jonnyarnold/wordclock/pictures/1_pieces.jpg

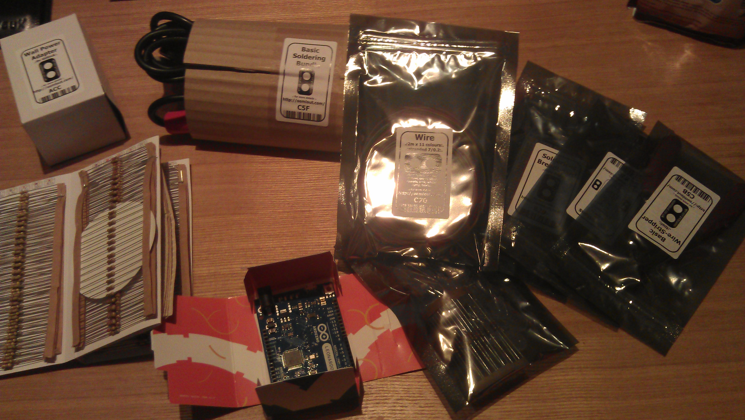
pictures/1_pieces.jpg
