jonnyarnold/wordclock/pictures/3_stencil_cork.jpg

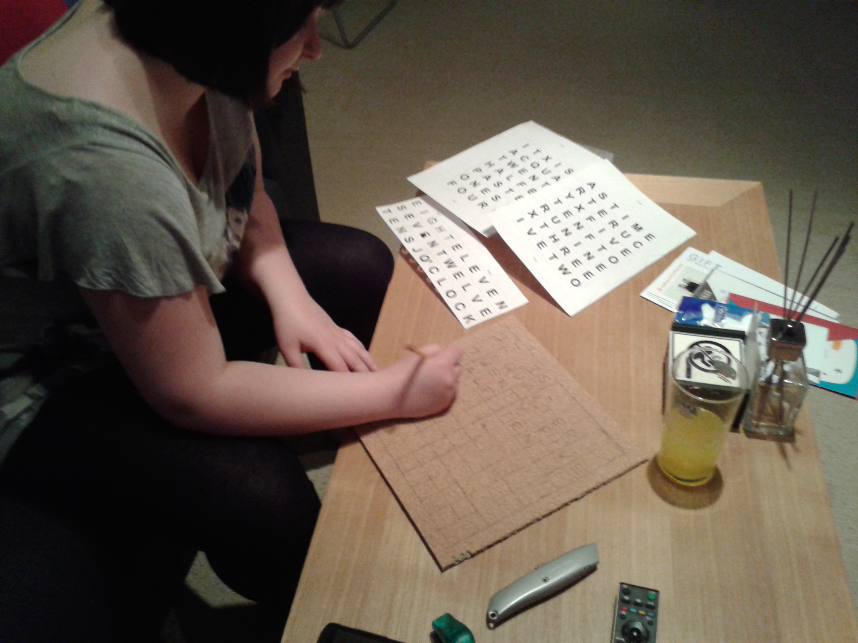
pictures/3_stencil_cork.jpg
