jonnyarnold/wordclock/pictures/4_cork_frame.jpg

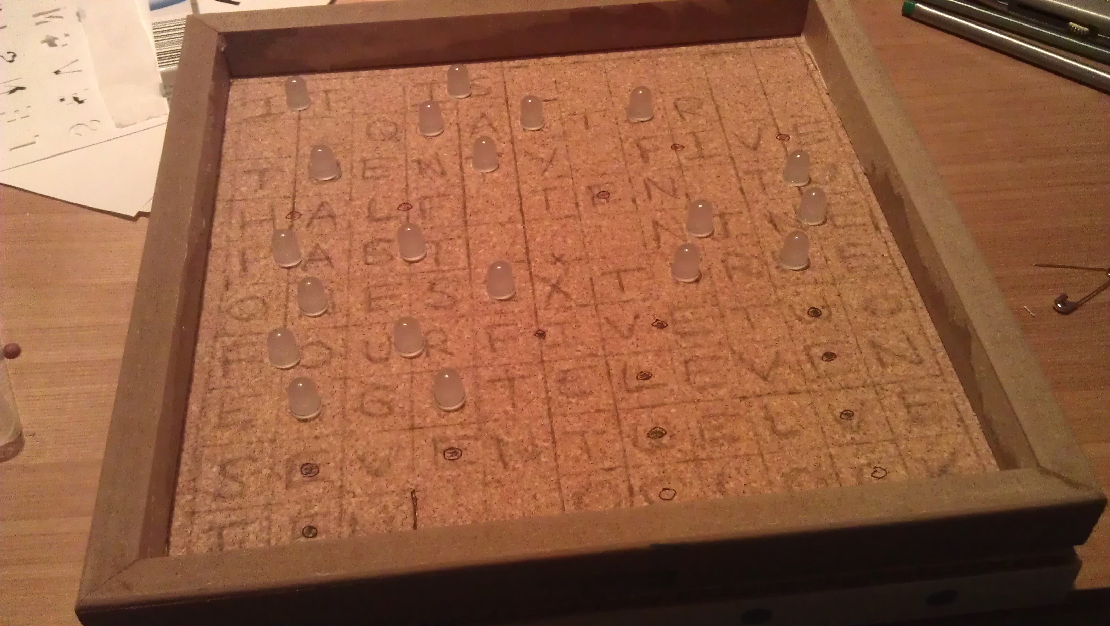
pictures/4_cork_frame.jpg
