jonnyarnold/wordclock/pictures/5_cork.jpg

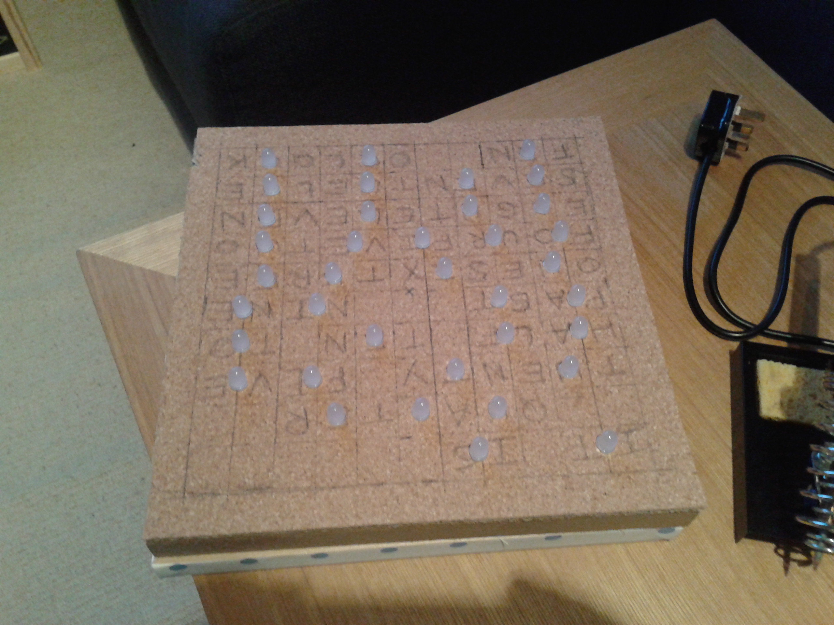
pictures/5_cork.jpg
