jonnyarnold/wordclock/pictures/6_arduino_cork.jpg

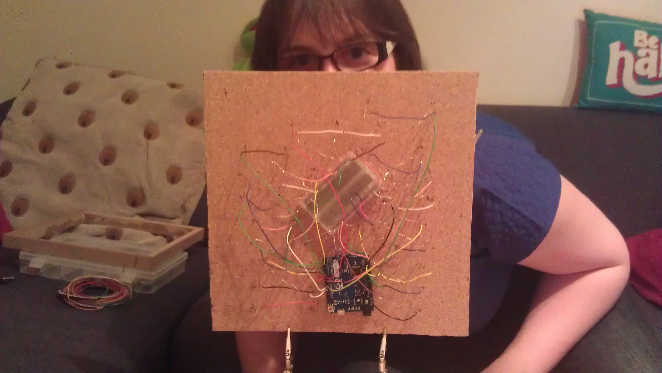
pictures/6_arduino_cork.jpg
