jonnyarnold/wordclock/pictures/7_tracing.jpg

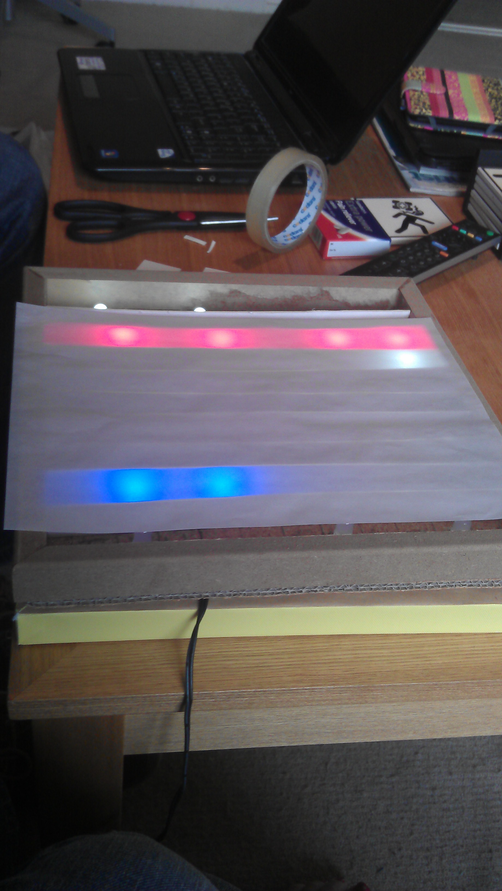
pictures/7_tracing.jpg
