jonnyarnold/wordclock/pictures/2_led_test.jpg

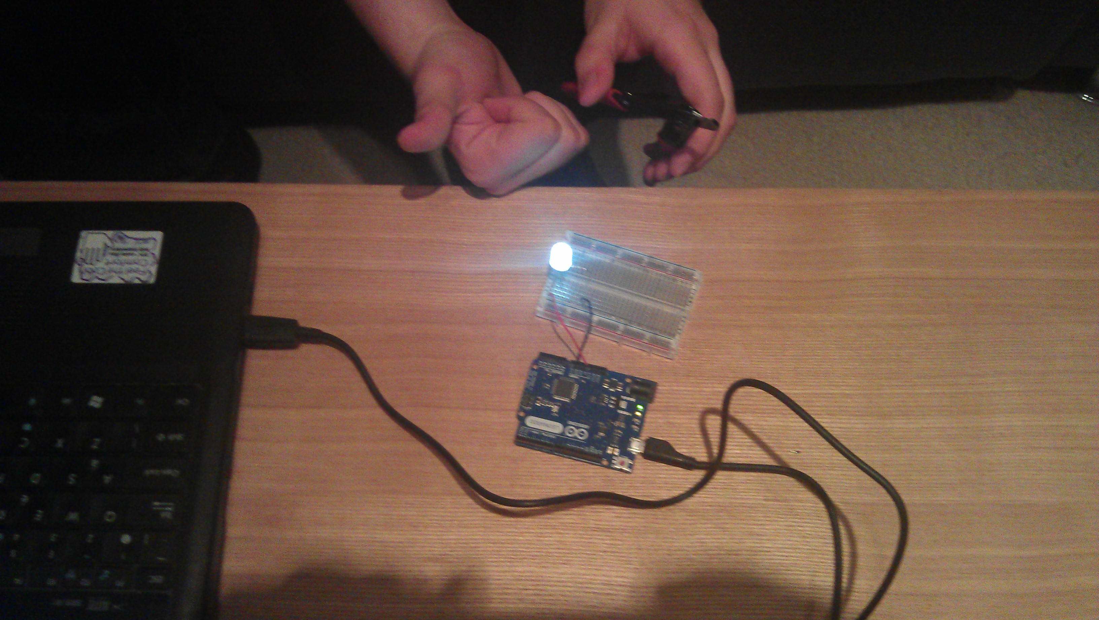
pictures/2_led_test.jpg
