jonnyarnold/wordclock/inos/pintest.ino

// PINTEST.INO
// Turns on all of the pins.

int pins[] = {
  0,
  1,
  2,
  3,
  4,
  5,
  6,
  7,
  8,
  9,
  10,
  11,
  12,
  13,
  18, // A0
  19,
  20,
  21,
  22,
  23
};
int numberOfPins = 20;

void setup() {                
  // initialize the digital pin as an output.
  for(int pinIdx = 0; pinIdx < numberOfPins; pinIdx++) {
    pinMode(pins[pinIdx], OUTPUT);   
    digitalWrite(pins[pinIdx], HIGH);  
  }
}

void loop() {
}
